saurabh-git-dev/CerealContainerLid/README.md

# Box
https://www.amazon.in/TEX-RO-Containers-Kitchen-Accessories-Transparent/dp/B0FR484TLT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
