saurabh-git-dev/CerealContainerLid/v1_axle_redesign/preview_1_section.png

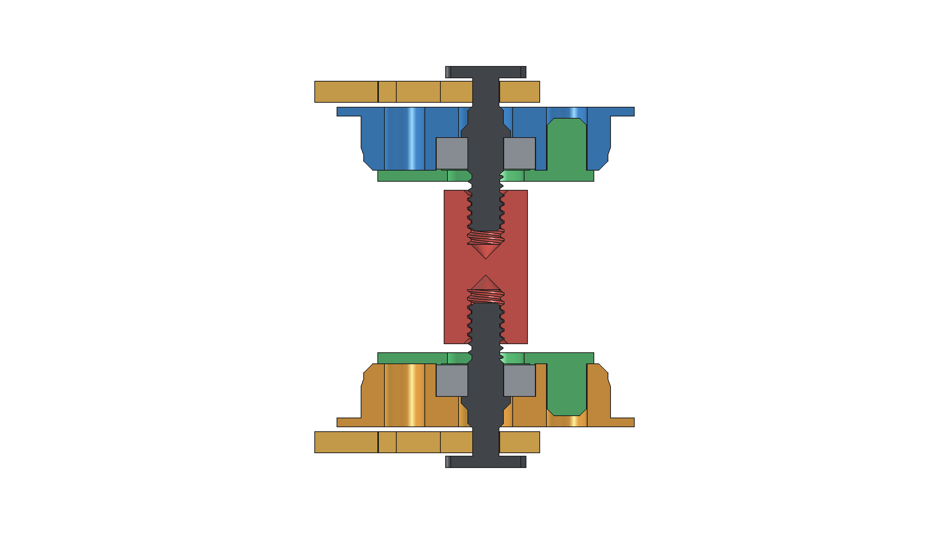
v1_axle_redesign/preview_1_section.png
