saurabh-git-dev/CerealContainerLid/v1_axle_redesign/preview_2_exploded.png

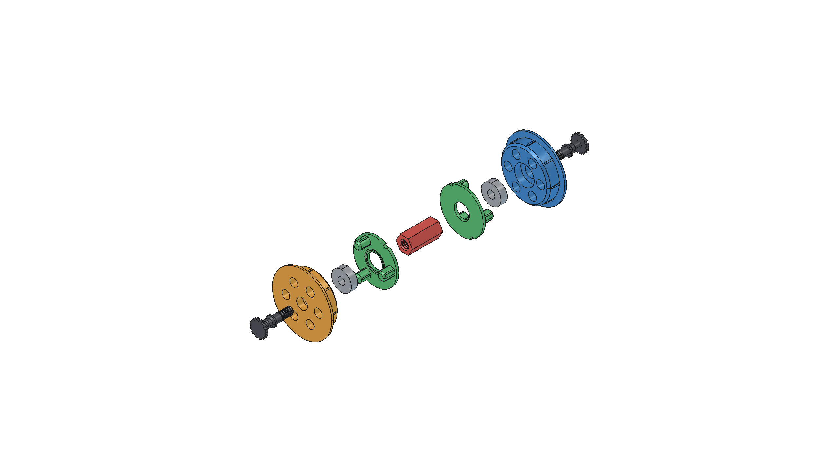
v1_axle_redesign/preview_2_exploded.png
