saurabh-git-dev/CerealContainerLid/v1_axle_redesign/preview_3_new_parts.png

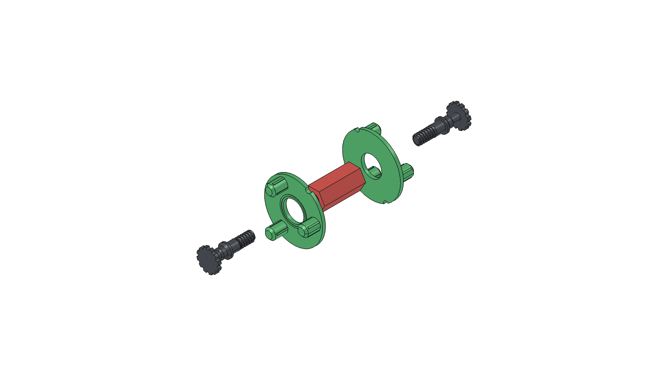
v1_axle_redesign/preview_3_new_parts.png
