saurabh-git-dev/CerealContainerLid/v1_axle_redesign/stl/StubAxle_x2.stl

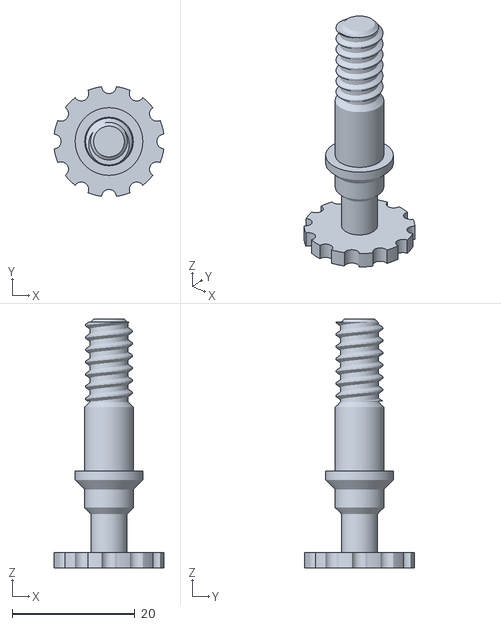
[picture p4: CAD file, 2026-11-12]
v1_axle_redesign/stl/StubAxle_x2.stl
17.8 x 17.8 x 40.5
