saurabh-git-dev/CerealContainerLid/v1_axle_redesign/V1_Axle_Reprint_Rod_Stubs_PETG_A1mini.3mf

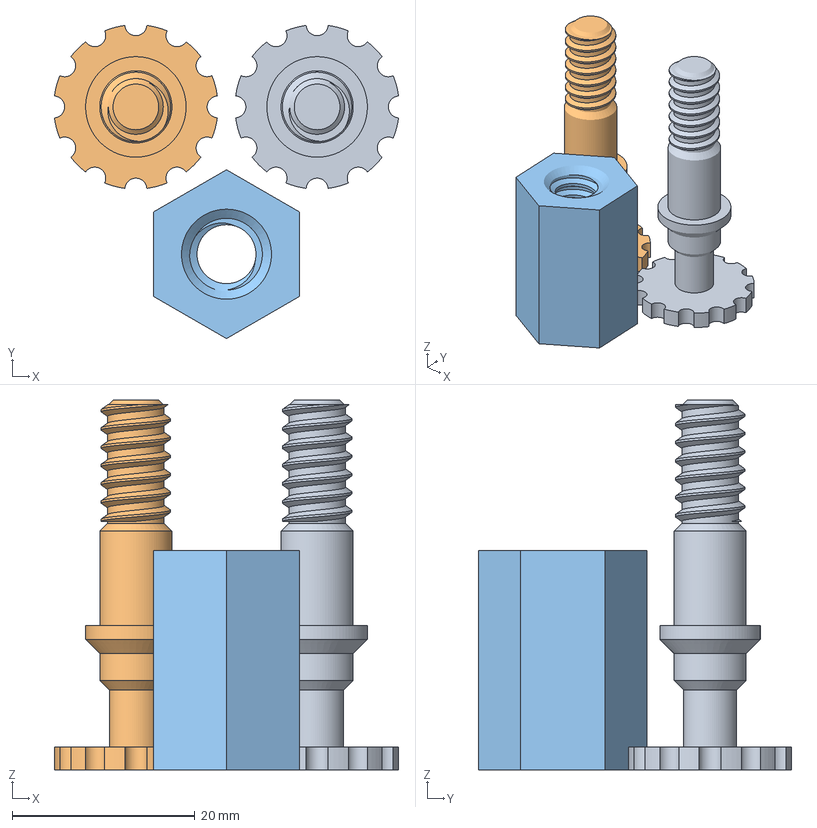
[picture p5: CAD file, 2026-11-12]
v1_axle_redesign/V1_Axle_Reprint_Rod_Stubs_PETG_A1mini.3mf
37.7 x 34.3 x 40.5 mm
StubAxle_x2_1
StubAxle_x2_2
MiddleRod_1
