saurabh-git-dev/CerealContainerLid/v2/bambu/work_latch_raft/latch.3mf

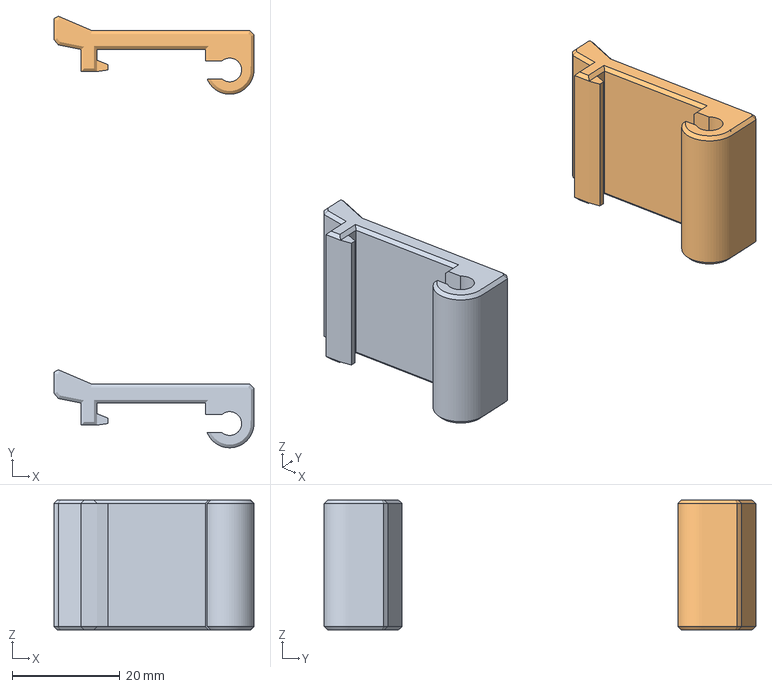
[picture p6: CAD file, 2026-11-12]
v2/bambu/work_latch_raft/latch.3mf
37.0 x 80.0 x 24.0 mm
Latch_x4_1
Latch_x4_2
