saurabh-git-dev/CerealContainerLid/v2/bambu/work_tpu_parts/tpu.3mf

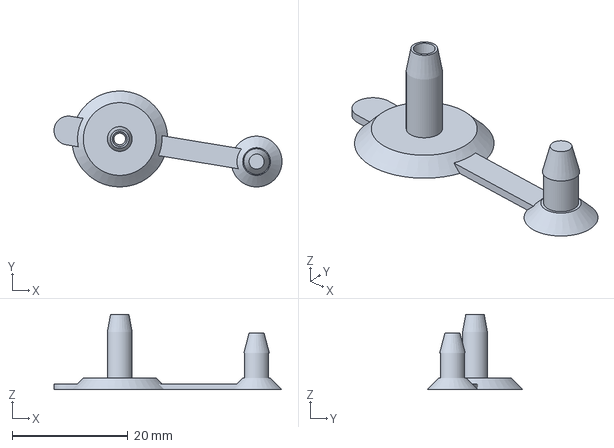
[picture p7: CAD file, 2026-11-12]
v2/bambu/work_tpu_parts/tpu.3mf
39.5 x 16.6 x 13.0 mm
