saurabh-git-dev/CerealContainerLid/v2/print/CerealLid_v2_TPU_eSUN_A1mini.3mf

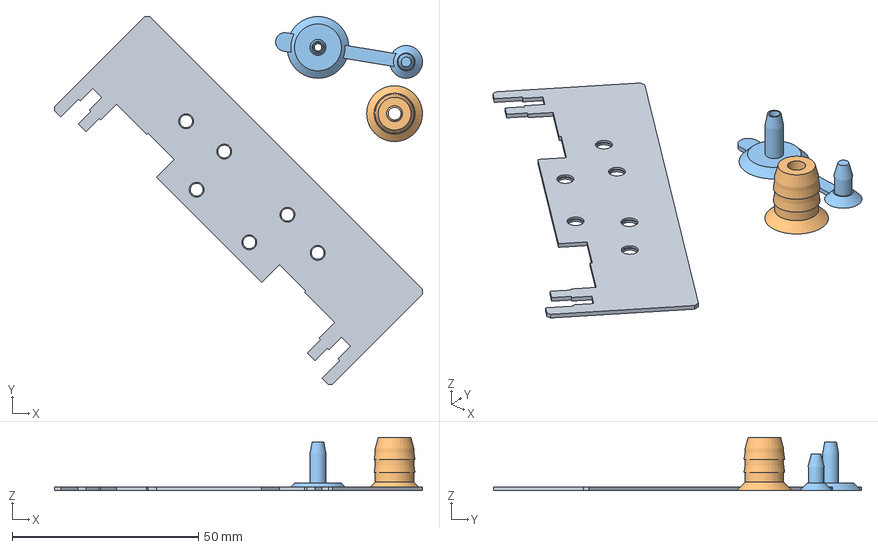
[picture p9: CAD file, 2026-11-12]
v2/print/CerealLid_v2_TPU_eSUN_A1mini.3mf
98.9 x 98.9 x 14.3 mm
TPU_SeamStrip_1
TPU_Grommet_1
TPU_CapTether_1
