saurabh-git-dev/CerealContainerLid/v2/stl_cereal/Lid_R.stl

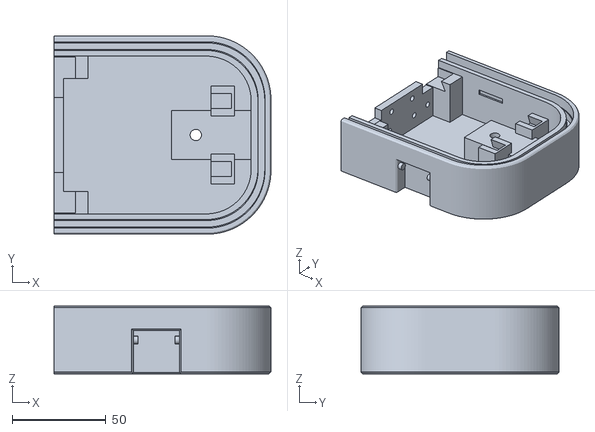
[picture p10: CAD file, 2026-11-12]
v2/stl_cereal/Lid_R.stl
115.6 x 105.6 x 36.0
