saurabh-git-dev/CerealContainerLid/v2/test_print/PrintTest_FirstLayer_Solid_PETG_A1mini.3mf

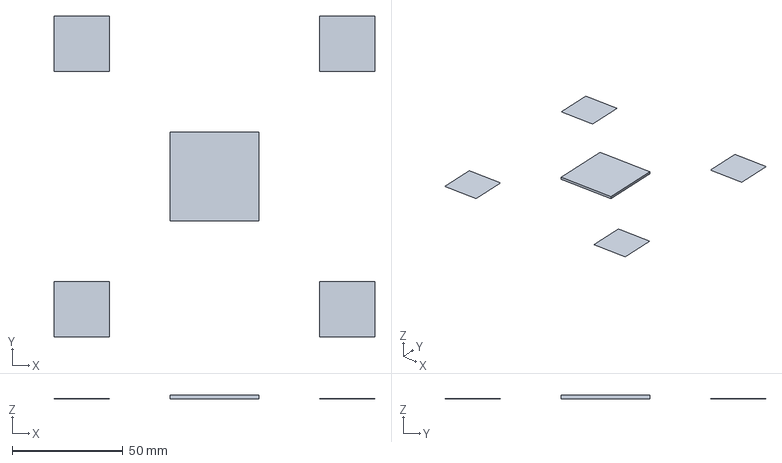
[picture p11: CAD file, 2026-11-12]
v2/test_print/PrintTest_FirstLayer_Solid_PETG_A1mini.3mf
145.0 x 145.0 x 1.60 mm
