saurabh-git-dev/CerealContainerLid/v1_axle_redesign/stl/MiddleRod.stl

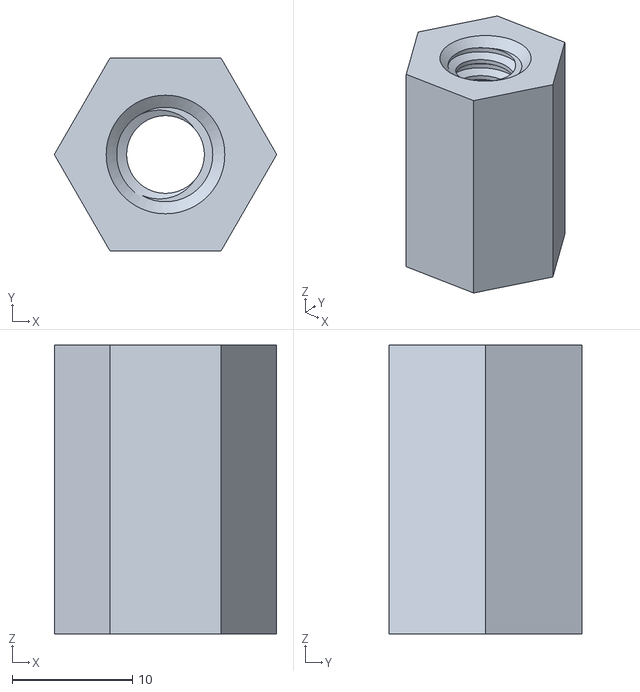
[picture p12: CAD file, 2026-11-12]
v1_axle_redesign/stl/MiddleRod.stl
18.5 x 16.0 x 24.0
