saurabh-git-dev/CerealContainerLid/v1_axle_redesign/V1_Axle_NewParts_PETG_A1mini.3mf

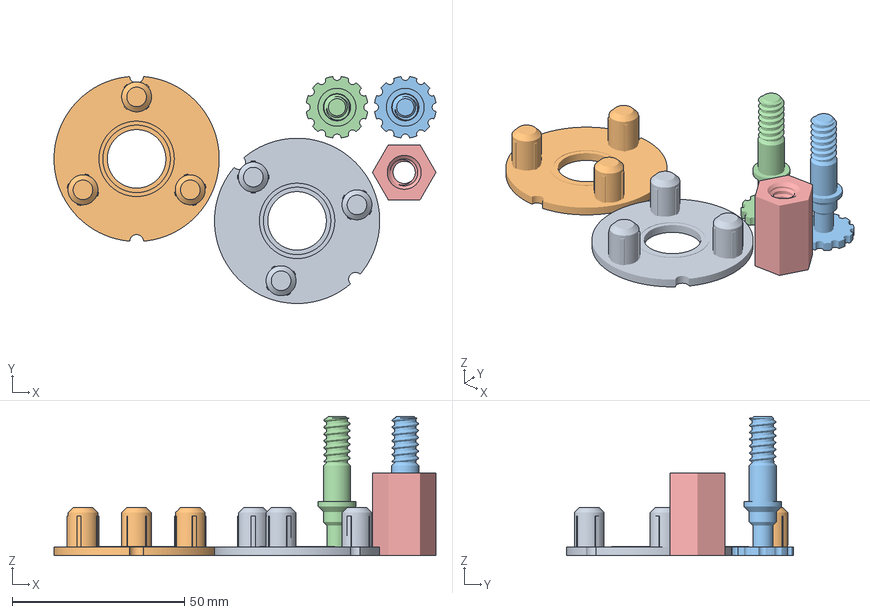
[picture p13: CAD file, 2026-11-12]
v1_axle_redesign/V1_Axle_NewParts_PETG_A1mini.3mf
111.0 x 65.9 x 40.5 mm
BearingCap_x2_1
BearingCap_x2_2
StubAxle_x2_1
StubAxle_x2_2
MiddleRod_1
