saurabh-git-dev/CerealContainerLid/v2/stl_cereal/TPU_CapTether.stl

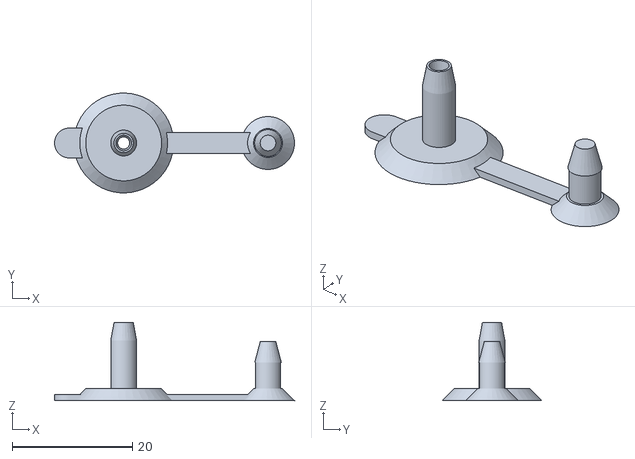
[picture p14: CAD file, 2026-11-12]
v2/stl_cereal/TPU_CapTether.stl
39.9 x 16.6 x 13.0
