saurabh-git-dev/CerealContainerLid/v1_axle_redesign/stl/BearingCap_x2.stl

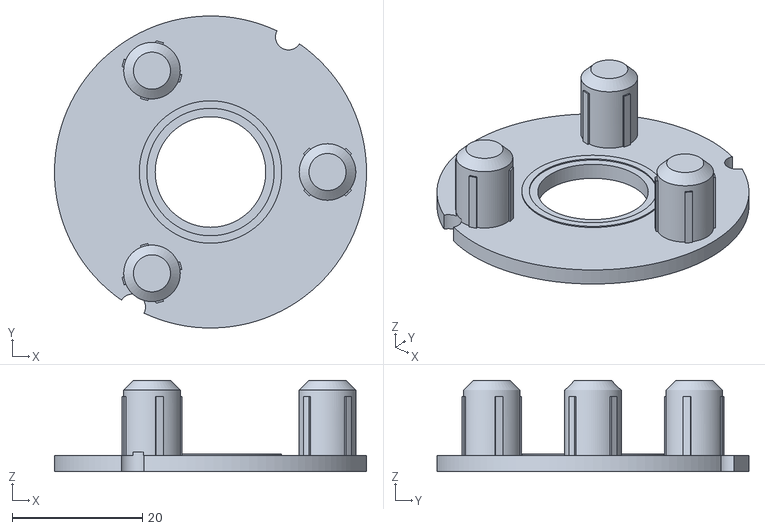
[picture p15: CAD file, 2026-11-12]
v1_axle_redesign/stl/BearingCap_x2.stl
48.0 x 48.0 x 14.0
