saurabh-git-dev/CerealContainerLid/v2/print/CerealLid_v2_Latches_x2_Raft_PETG_A1mini.3mf

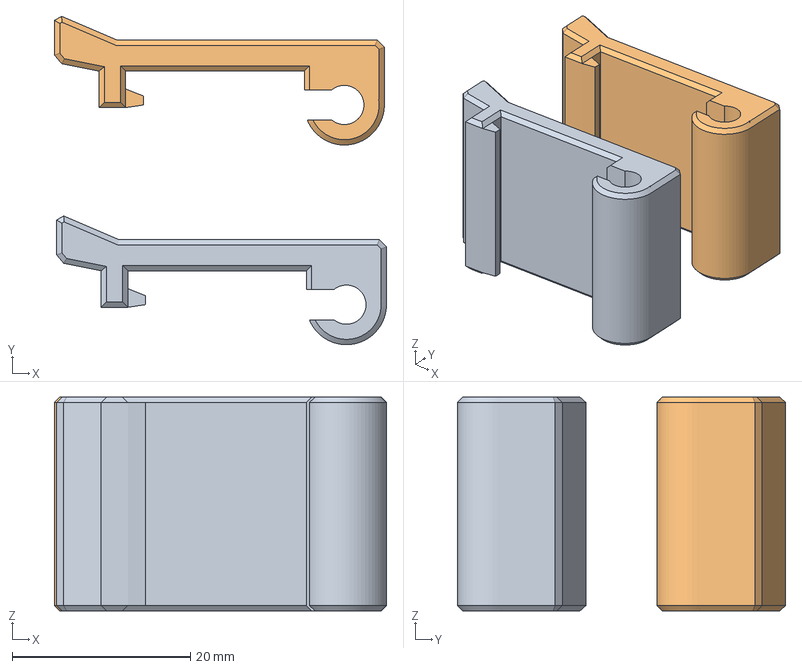
[picture p16: CAD file, 2026-11-12]
v2/print/CerealLid_v2_Latches_x2_Raft_PETG_A1mini.3mf
37.3 x 36.9 x 24.0 mm
Latch_x4_1
Latch_x4_2
