saurabh-git-dev/CerealContainerLid/v2/stl_cereal/Lid_L.stl

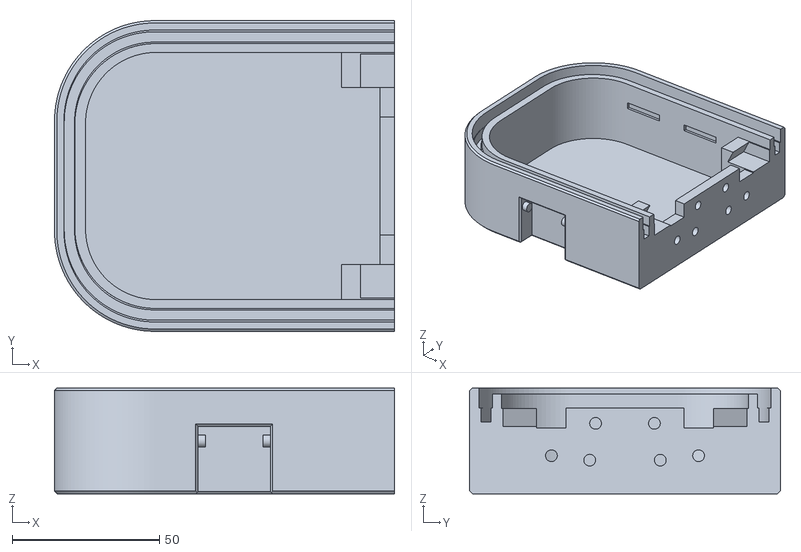
[picture p17: CAD file, 2026-11-12]
v2/stl_cereal/Lid_L.stl
115.6 x 105.6 x 36.0
