saurabh-git-dev/CerealContainerLid/v2/stl_cereal/TPU_SeamStrip.stl

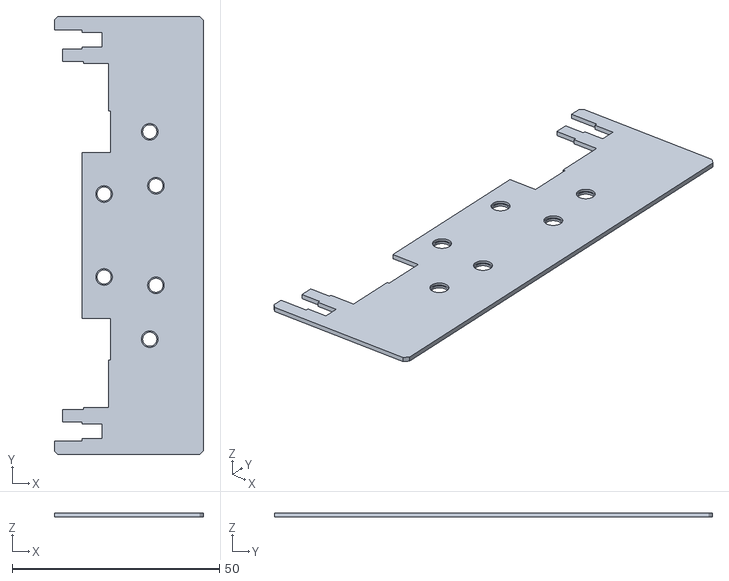
[picture p19: CAD file, 2026-11-12]
v2/stl_cereal/TPU_SeamStrip.stl
36.0 x 105.6 x 1.00
