saurabh-git-dev/CerealContainerLid/(list of files, cad)

Other CAD files:
v2/print/CerealLid_v2_TPU_Cap_only_A1mini.3mf
v2/test_print/PrintTest_FirstLayer_Solid.stl
v1/print/CerealLid_v1_TPU_eSUN_A1mini.3mf
